QuantuMope/grimdor-shoe-tying-robot/Design Conception Drawings/gear box 1.png

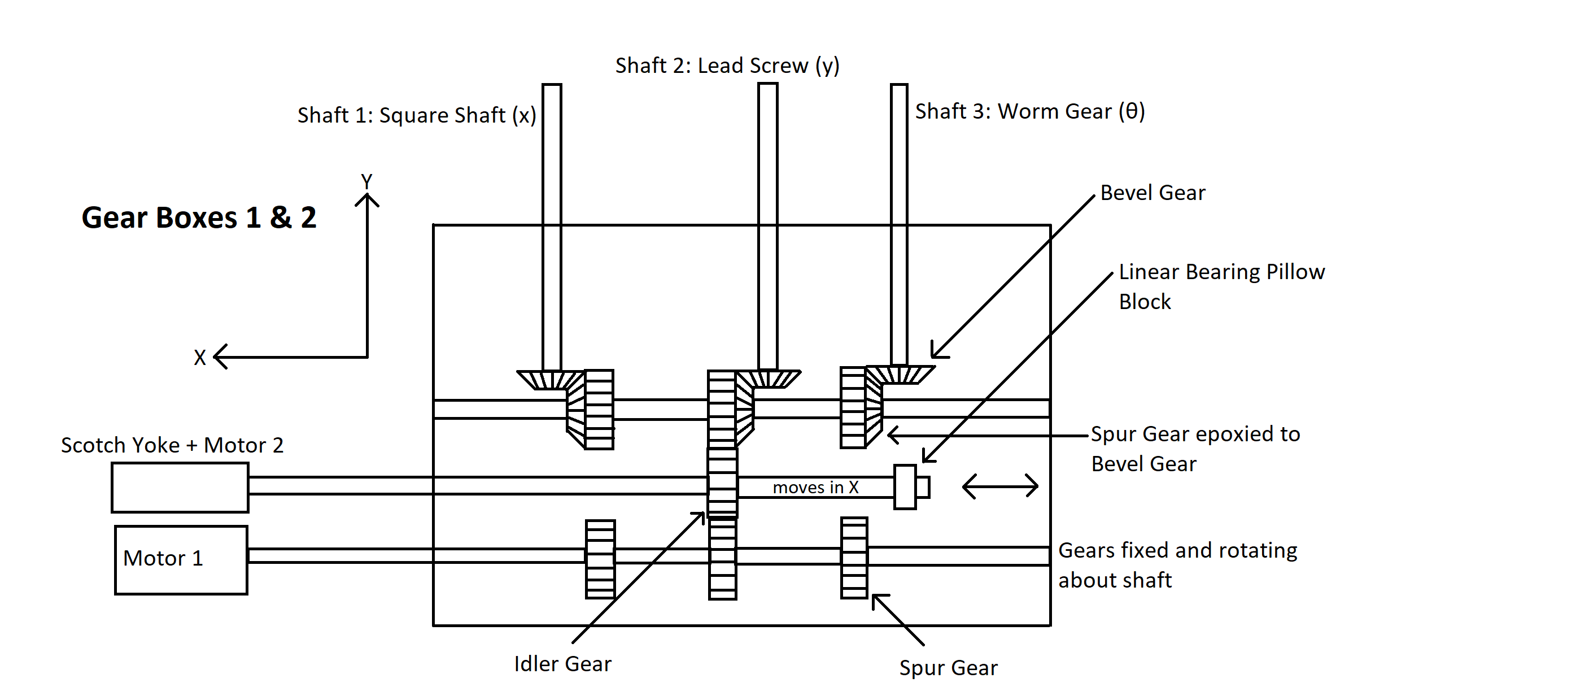
Design Conception Drawings/gear box 1.png
