QuantuMope/grimdor-shoe-tying-robot/Design Conception Drawings/gear box 3 top view.png

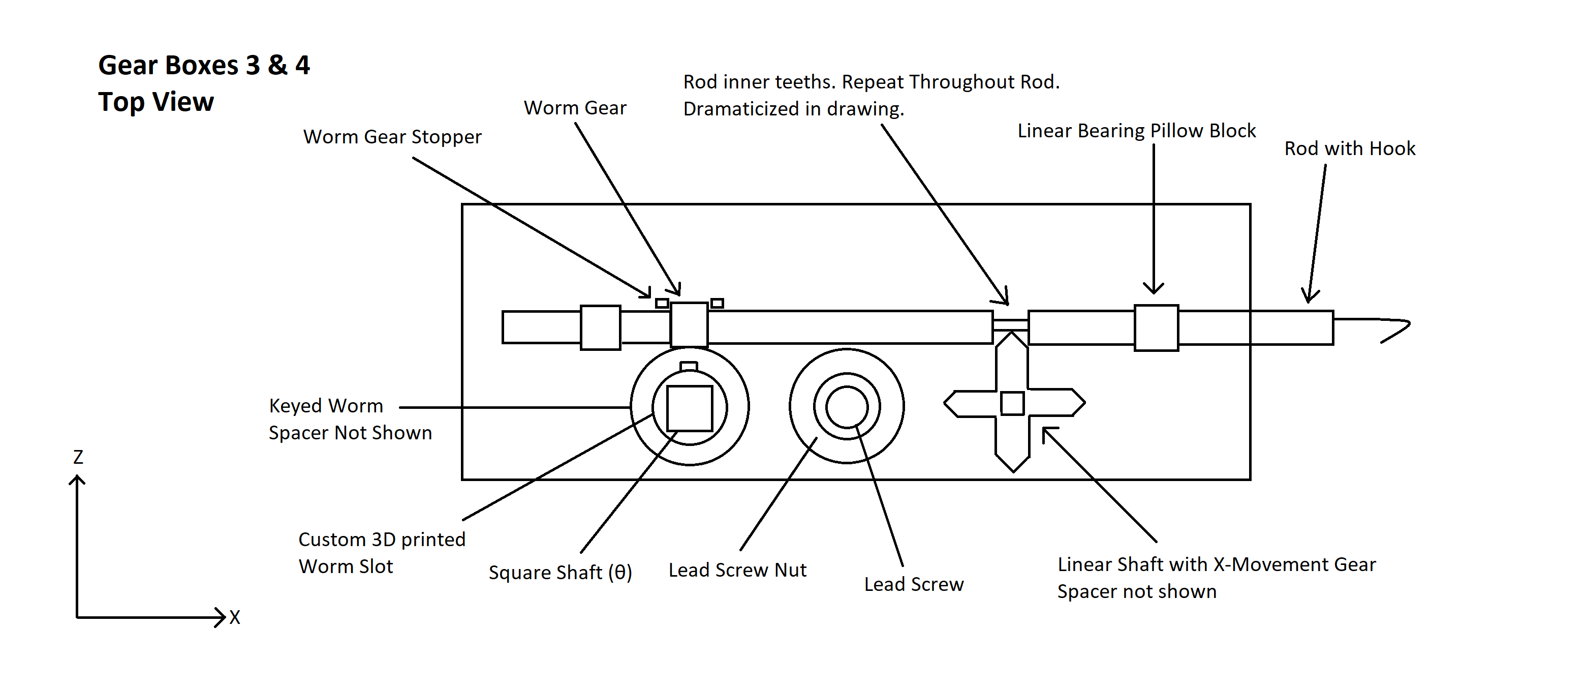
Design Conception Drawings/gear box 3 top view.png
