QuantuMope/grimdor-shoe-tying-robot/Design Conception Drawings/Gear box 3.png

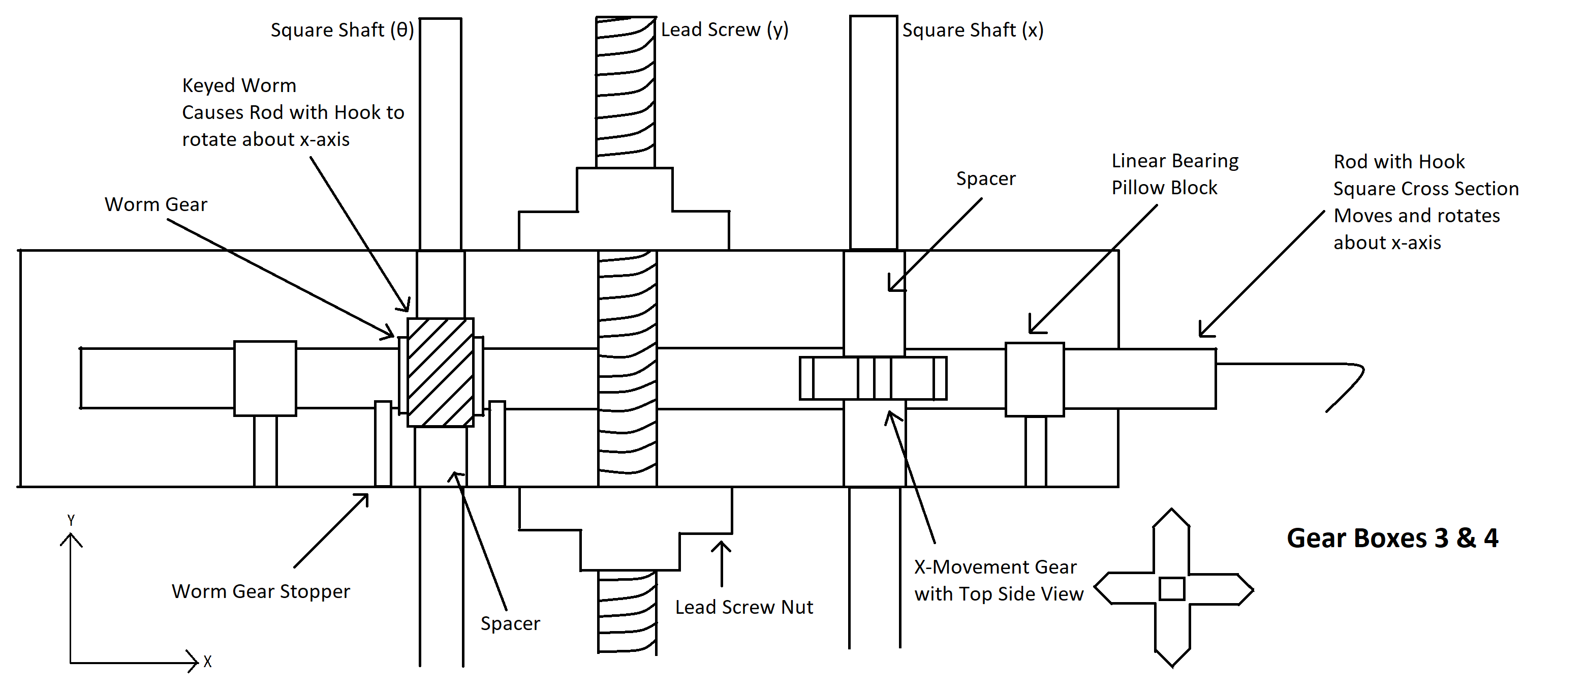
Design Conception Drawings/Gear box 3.png
