QuantuMope/grimdor-shoe-tying-robot/Design Conception Drawings/Gear Box Configuration.png

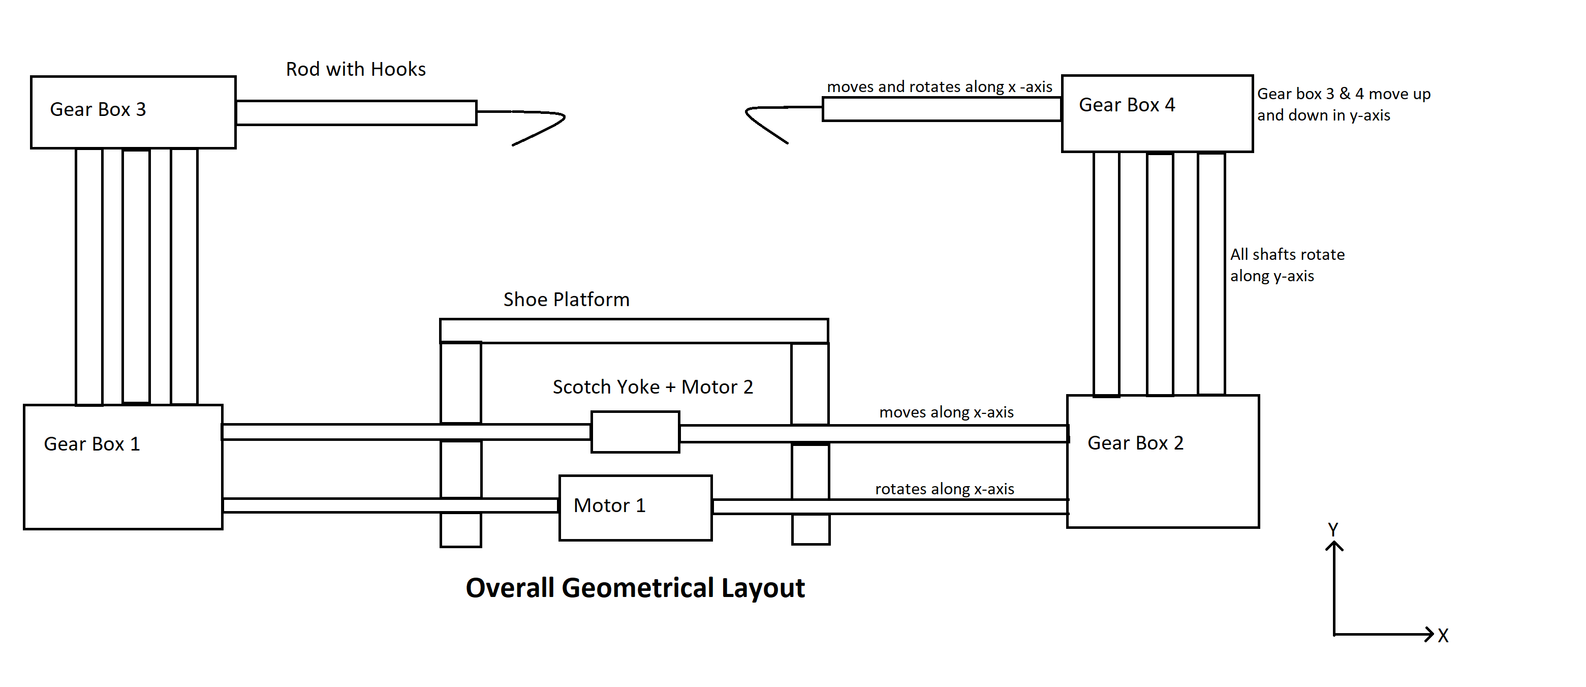
Design Conception Drawings/Gear Box Configuration.png
