QuantuMope/grimdor-shoe-tying-robot/Design Conception Drawings/STM Circuit Schematic Final.PNG

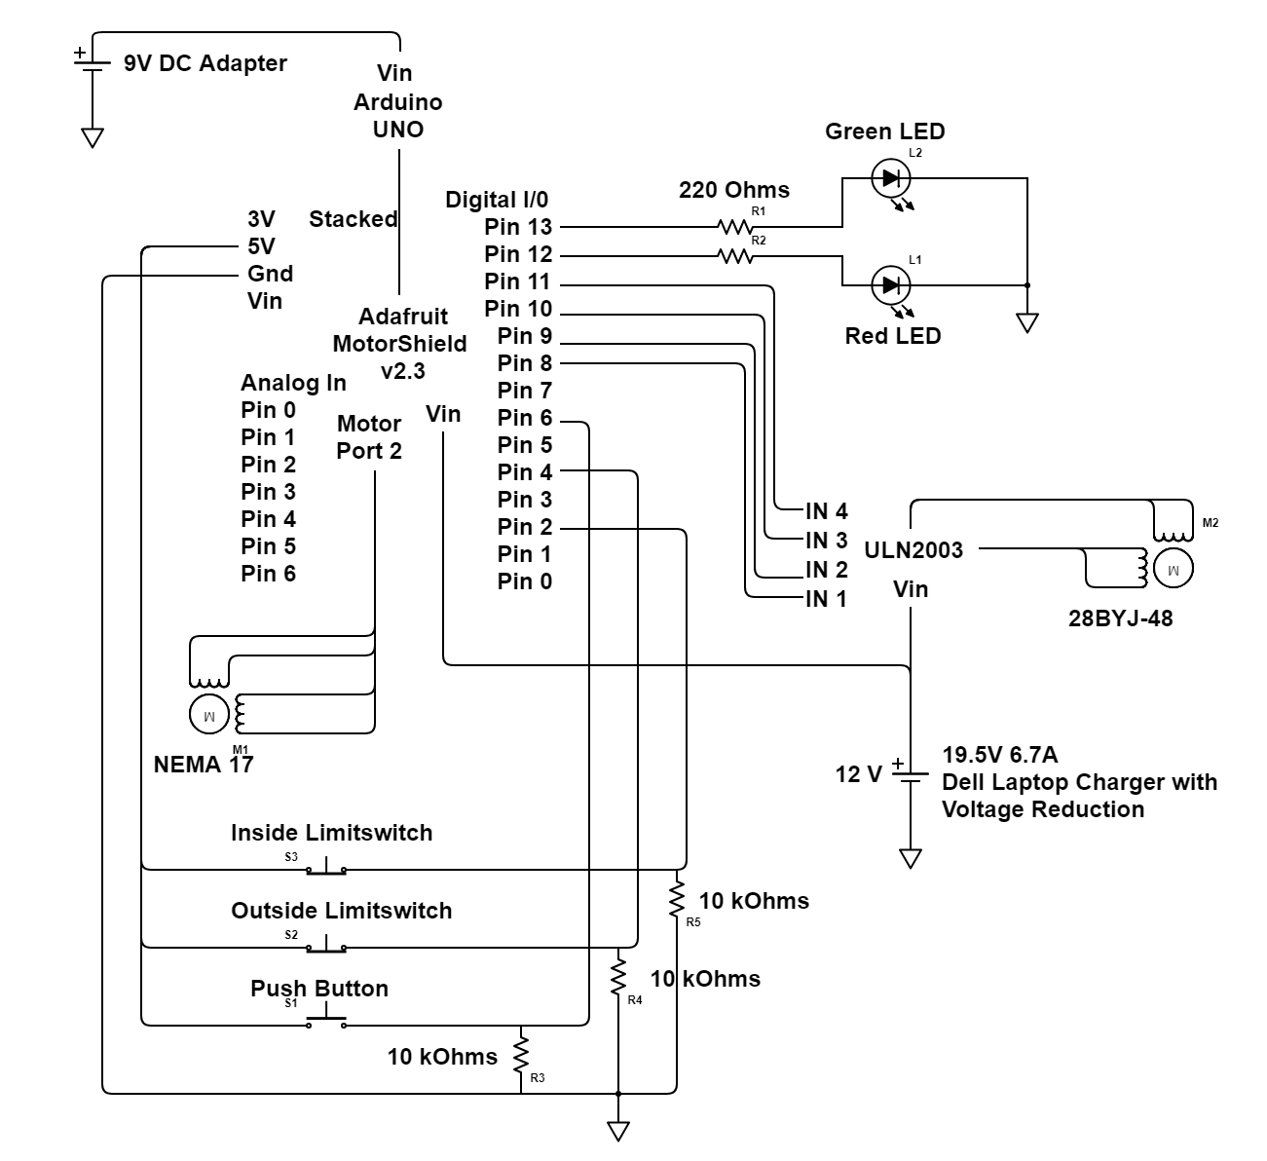
Design Conception Drawings/STM Circuit Schematic Final.PNG
