QuantuMope/grimdor-shoe-tying-robot/Final_Render/FinalAssemblyRender.JPG

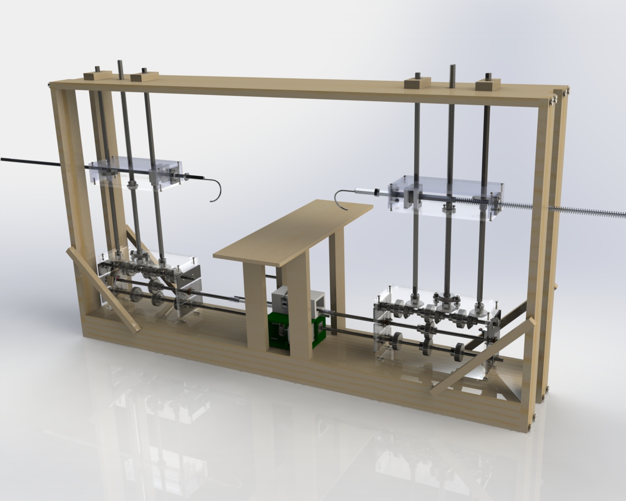
Final_Render/FinalAssemblyRender.JPG
