QuantuMope/grimdor-shoe-tying-robot/Shoe Tying Robot Report.PDF

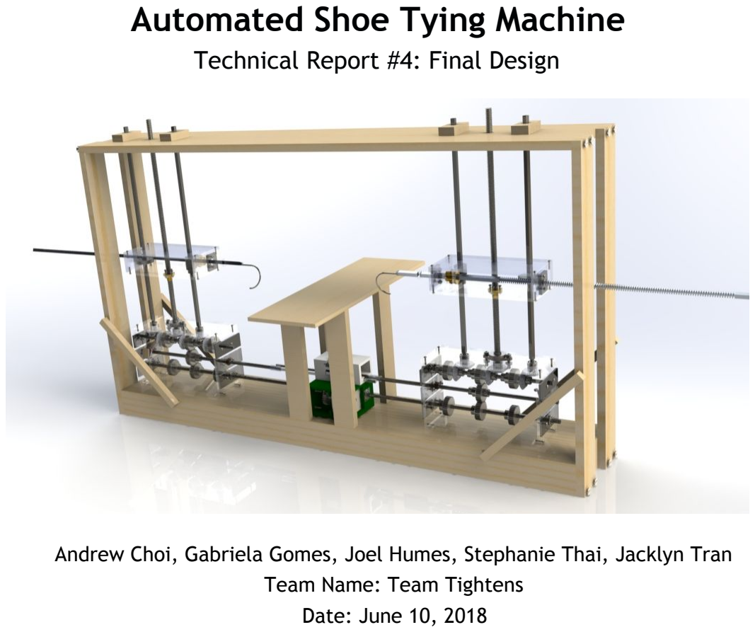
[picture p8: page 1]

Automated Shoe Tying Machine
Technical Report #4: Final Design

Andrew Choi, Gabriela Gomes, Joel Humes, Stephanie Thai, Jacklyn Tran

Team Name: Team Tightens
Date: June 10, 2018

Introduction

Mission Statement
Having neatly laced and tied shoes on our feet is a luxury the majority of us take for granted. Tying our shoes is a skilled learned at a young age that becomes a second nature ability. As we age though, our hand dexterity may decrease, our back begins to ache, and we lose flexibility. All these factors can lead to losing our ability to tie our shoes. Imagine being hindered from performing one of your earliest skills due to your age, a new disability, or during the challenges of pregnancy. It can be very disheartening to lose your long held ability to wear shoes that define part of your style and personality and be forced into settling for simple strapped shoes and slip ons that just aren’t the same. In order to challenge this issue and bring back a sense of confidence, dignity, and independence to people who’ve been forced into wearing laceless shoes, our team’s mission is to develop a fully automated shoe tying machine that works for them. There exist hobbyist machines that demonstrate knot tying capabilities but none that would be of use for the elderly, as all are not fully automated and require the user to secure the laces to preset locations. Our primary sponsor is Professor Moore from the University of California, Davis and we were given the directive to design based on our main competition evaluation criteria: time it takes to tie a shoe, the amount of energy the machine consumes, and the machine’s overall success rate over multiple runs. Although the driving factor in the design parameters lies with winning the competition, we hope that our shoe tying machine can act as a precursor for a more practical future iteration of a shoe tying machine that can be widely used and benefit the elderly and disabled community, our primary stakeholders.

Problem Description
Often, the elderly and/or disabled have difficulties grabbing and tying their shoelaces on their own, so they have to resort to wearing velcro shoes, slip ons, or seek assistance from a care provider. Therefore, an automated shoe tying machine that is capable of tying a safe and lasting initial and final standard shoelace knot (shown in Figure 1 below), without requiring human assistance, has been designed and manufactured so that the user can gain more independence.

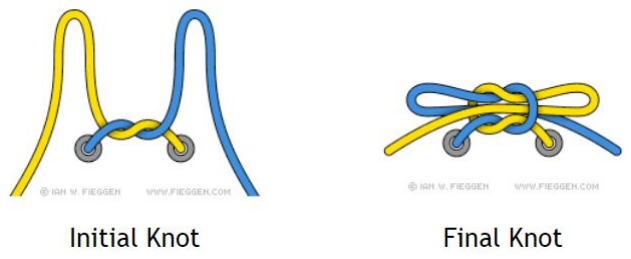
[picture p9: figure]

Figure 1. Examples of the initial knot and final standard shoelace knot [1].

In creating such a machine, the problem was broken down into several, more manageable sub-problems as follows:
Sub-Problems
1. Power - How will the shoe tying machine be powered?
2. Controls - How will the shoe tying machine be automated?
3. Actuators - What type of motors will be used?
4. Lace Grabbing Mechanism - How will the shoe tying machine grab the laces?
5. Moving Mechanism - How will the two motors move the lace grabbing mechanism?

These sub-problems address the major functions of the shoe tying machine that our design concept must address. Overall, a shoe tying machine will enable more independence for the elderly and disabled in tying their shoes. Farther downstream market applications may include use of the machine as a novelty device in a shoe store or assistive device in well equipped locker rooms.

Existing External Concepts/Solutions
Several external concepts were researched to aid the design of the shoe tying machine. Among these external concepts, no fully automated machine was found but certain components of these concepts inspired ideas. One external concept is a patented shoe tying device created by Leah D. Holmes et al. [2]. A schematic of this device can be seen in Figure 8 of the Appendix. This machine was designed to assist individuals with at least one able hand. Although our machine must be fully automated, we gained valuable insight from the design’s use of one motor for symmetrical motion. Another device uses rods and fixture patterns to secure and tie a free string into the final knot; the string is tied as the fixtures are carefully removed layer by layer and the rods are lowered simultaneously [3]. Although this device did not tie the knot with a string attached to a shoe, insight was gained by the simplicity of using layers to tie a knot. Furthermore, the usage of simple rods with hooks for the lace grabbing mechanism was inspired by a shoe tying robot created by Andrew Stone, a mechanical engineering student at the University of Minnesota [4].

Needs, Specifications, and Standards

Since the project is meant for a competition rather than commercial viability, the needs derived from competition evaluation and parameters, which are listed below, are of highest priority and essentially drive the specifications of the shoe tying machine. Competition Parameters

1. Must only use up to two motors.
2. Must be powered through a wall outlet.
3. Must be able to grab the shoelaces without human assistance.
4. Must tie a standard shoe knot on a stationary shoe.
5. Must stay under a $600 budget.

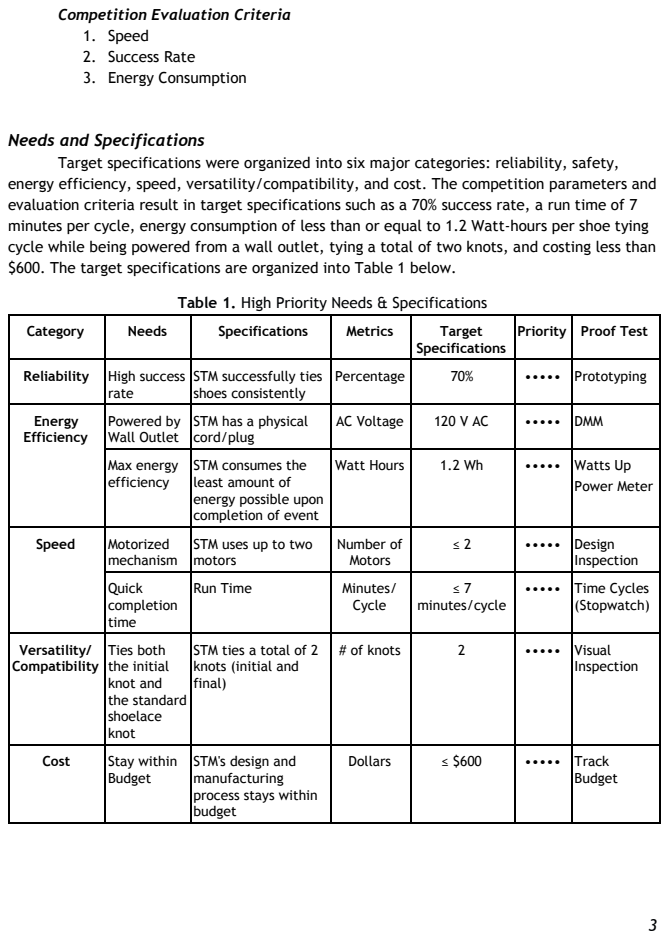
[picture p10: page 4]
Table 1.; High Priority Needs & Specifications

Competition Evaluation Criteria
1. Speed
2. Success Rate
3. Energy Consumption

Needs and Specifications
Target specifications were organized into six major categories: reliability, safety,
energy efficiency, speed, versatility/compatibility, and cost. The competition parameters and
evaluation criteria result in target specifications such as a 70% success rate, a run time of 7
minutes per cycle, energy consumption of less than or equal to 1.2 Watt-hours per shoe tying
cycle while being powered from a wall outlet, tying a total of two knots, and costing less than
$600. The target specifications are organized into Table 1 below.

Category | Needs | Specifications | Metrics | Target Specifications | Priority | Proof Test

Reliability | High success rate | STM successfully ties shoes consistently | Percentage | 70% | ••••• | Prototyping

Energy Efficiency | Powered by Wall Outlet | STM has a physical cord/plug | AC Voltage | 120 V AC | ••••• | DMM

Max energy efficiency | STM consumes the least amount of energy possible upon completion of event | Watt Hours | 1.2 Wh | ••••• | Watts Up Power Meter

Speed | Motorized mechanism | STM uses up to two motors | Number of Motors | ≤ 2 | ••••• | Design Inspection

Quick completion time | Run Time | Minutes/ Cycle | ≤ 7 minutes/cycle | ••••• | Time Cycles (Stopwatch)

Versatility/ Compatibility | Ties both the initial knot and the standard shoelace knot | STM ties a total of 2 knots (initial and final) | # of knots | 2 | ••••• | Visual Inspection

Cost | Stay within Budget | STM's design and manufacturing process stays within budget | Dollars | ≤ $600 | ••••• | Track Budget

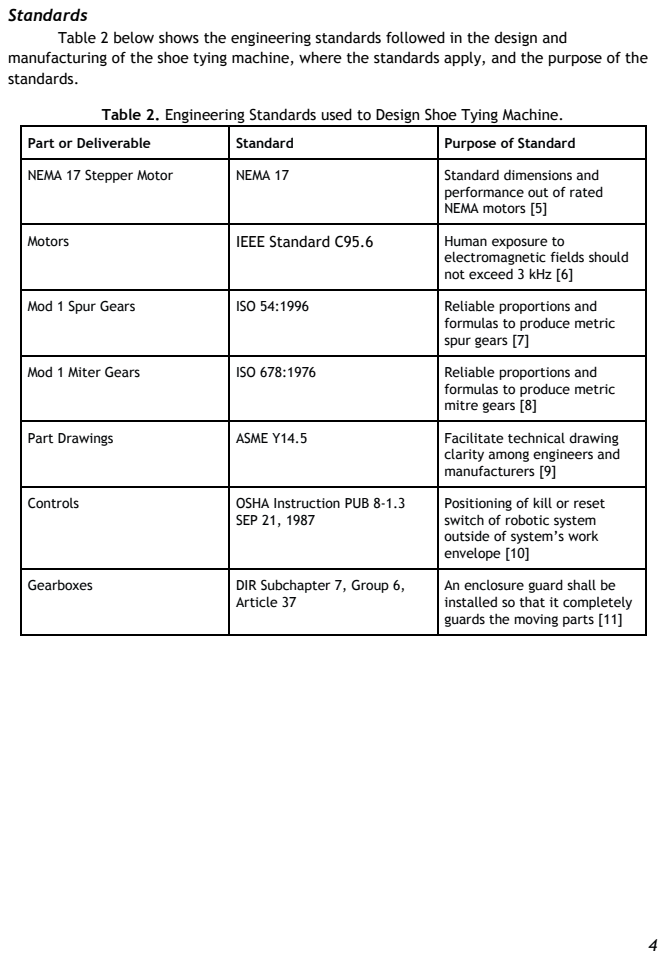
[picture p11: page 5]
Mod 1 Miter Gears; ISO 678:1976; Reliable proportions and; Part Drawings; ASME Y14.5; Facilitate technical drawing; Controls; OSHA Instruction PUB 8-1.3; SEP 21, 1987; Gearboxes; DIR Subchapter 7, Group 6,; Article 37

Standards
Table 2 below shows the engineering standards followed in the design and
manufacturing of the shoe tying machine, where the standards apply, and the purpose of the
standards.

Table 2. Engineering Standards used to Design Shoe Tying Machine.

Part or Deliverable | Standard | Purpose of Standard

NEMA 17 Stepper Motor | NEMA 17 | Standard dimensions and performance out of rated NEMA motors [5]

Motors | IEEE Standard C95.6 | Human exposure to electromagnetic fields should not exceed 3 kHz [6]

Mod 1 Spur Gears | ISO 54:1996 | Reliable proportions and formulas to produce metric spur gears [7]

formulas to produce metric
mitre gears [8]

clarity among engineers and
manufacturers [9]

Positioning of kill or reset
switch of robotic system
outside of system’s work
envelope [10]

An enclosure guard shall be
installed so that it completely
guards the moving parts [11]

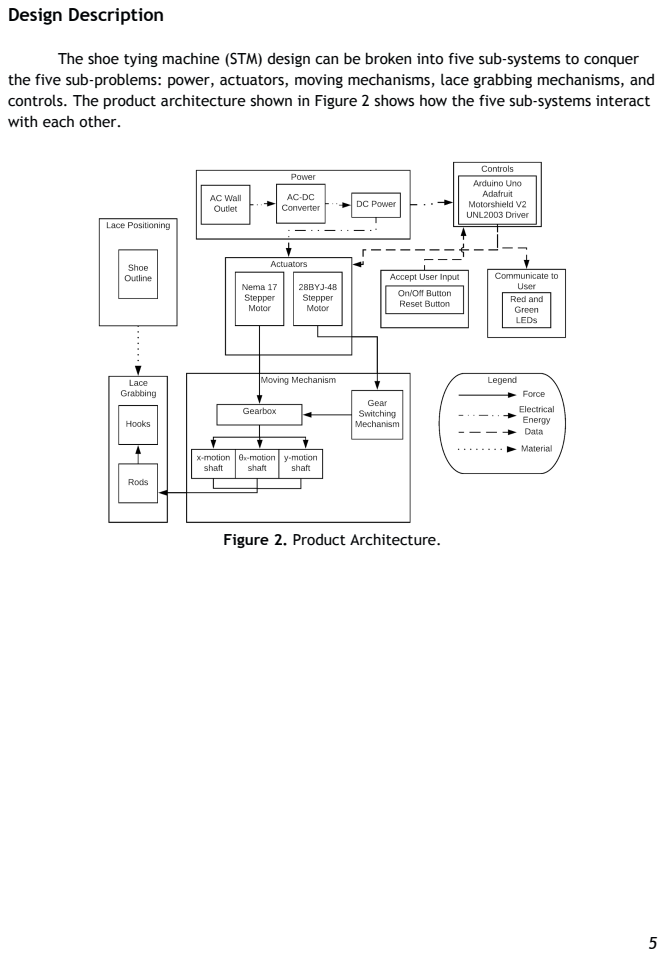
[picture p12: page 6]
Design Description; Figure 2.; Product Architecture.

The shoe tying machine (STM) design can be broken into five sub-systems to conquer
the five sub-problems: power, actuators, moving mechanisms, lace grabbing mechanisms, and
controls. The product architecture shown in Figure 2 shows how the five sub-systems interact
with each other.

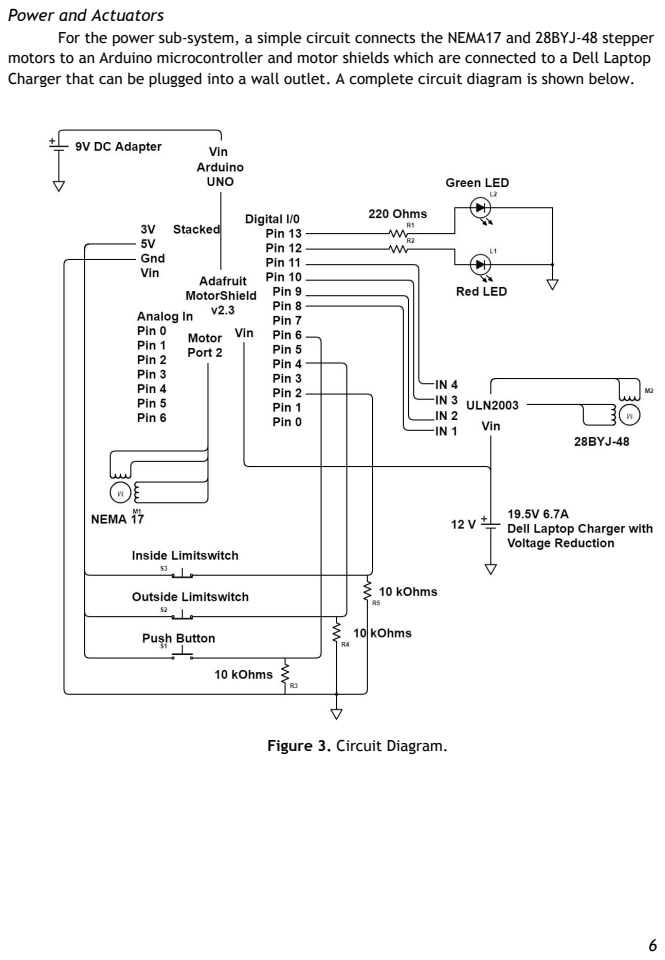
[picture p13: page 7]

Power and Actuators
For the power sub-system, a simple circuit connects the NEMA17 and 28BYJ-48 stepper
motors to an Arduino microcontroller and motor shields which are connected to a Dell Laptop
Charger that can be plugged into a wall outlet. A complete circuit diagram is shown below.

Figure 3. Circuit Diagram.

Moving Mechanisms
The two motors actuate four gearboxes, two on each side of the shoe platform as shown below.

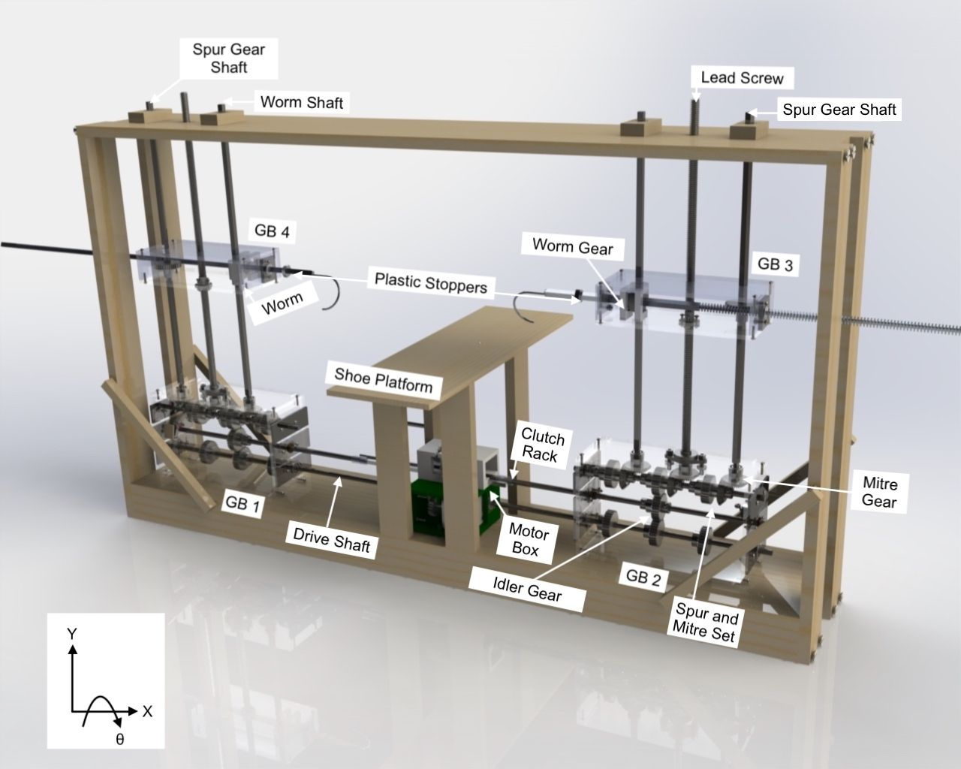
[picture p14: figure]

Figure 4. Rendered CAD model with Integral Parts Labeled.

In the bottom gearboxes (GB1&2), 30 tooth spur and mitre gears transmit power from the NEMA 17 motor and translate horizontal shaft rotation to vertical shaft rotation. The NEMA 17 motor drives a shaft connected to GB1&2 on the two sides of the shoe platform. On the drive shaft are a total of six 30 tooth spur gears, three inside each gearbox on each side. A 30 tooth idler gear in each gearbox transmits rotations from the bottom spur gears to the spur-mitre gear sets on the top shafts. The 28BYJ-48 motor controls the horizontal movement 1 of the idler gears using a rack and pinion system; the racks translate the idler gear shafts horizontally. The idler gear then engages with corresponding spur-mitre gear sets, and transfers power from the drive shaft to the spur-mitre gear sets which drive the movement of two rods with hooks in the top gearboxes (GB3&4). Often times the clutch gear teeth aligns perfectly with another set of teeth and jams the clutch mechanism. Rubber bands are used to hold the clutch motorbox in place while also giving it the ability to shift slightly until the clutch is able to fix itself. The top gearbox is controlled by two square shafts and a lead screw

1 Mitre gear epoxied to a spur gear.

on each side. The lead screw controls translational y-axis movement. Square shafts are used so that the top gearboxes can move along the shafts and the gears on the shafts can be engaged and driven by each shaft at any point along the shaft. The square shaft closest to the shoe platform (Worm Shaft) drives a worm and a 20 tooth worm gear with a modulus of 1 which controls the rotation of the rod about the x-axis. The worm was purchased and it had a circular bore so an acrylic insert sits inside the worm using the set screw and has a square bore that would allow the square shaft to rotate the worm. Last, the square shaft farthest away from the shoe platform (Spur Gear Shaft) controls the translational x-axis movement of the rod by driving a 33 tooth, modulus 1 spur gear with a 0.25”x0.25” square bore. The hook rod is designed to have 12.89” of rack with a modulus of 1 and is driven by the spur gear. The spur gear was restricted by the worm and worm gear because the distance between the worm and worm gear needed to match the distance between the spur and hook rod so that the hook rod would be straight while both gear systems maintained a strong mesh. Collars were used to secure the positions of the gears and shafts.
After multiple test iterations of the shoe tying algorithm using a simple wooden prototype, it was determined that a 0.5” offset of the hooks was the ideal position. This offset determined most of the design aspects because everything under the hooks had to be offset in order for the hooks to be offset. Slots were designed in the side plates of GB1&2 to allow for adjustability of the gears in order to achieve the best gear meshing. Two different sets of slots were designed into the side plates: one was for the drive shaft and the other for the idler gear and spur-mitre gear sets. The drive shaft slots were identical for both GB1&2 because there was only one drive shaft. But the slots for the idler and spur-mitre gear sets are offset by 0.25” from the drive shaft slots in opposite directions on each gearbox so that the total offset is 0.5”.

Lace Grabbing Mechanism
The shoelaces were controlled with a pair of hooks. Two paper clips with a diameter of 0.1” were used to make hooks with 0.75” diameters designed to reach across the 0.5” offset and grab the opposing laces. The rod was designed to be a square shaft to allow translational movement through the worm gear but also be able to be rotated by the worm gear when needed. Since the worm gears had circular bores, acrylic inserts with a square bore were placed inside the worm bear bore. The set screw of the worm gear was used to hold the acrylic inserts in place. The square bore would catch the square rod and rotate the rod as the worm gear rotated. There are also plastic stoppers on the hook rod about 3.34” away from the hook. These stoppers prevent the shoelaces from moving along the hook rod as it moves inwards toward the shoe. They stop the shoelaces so that the hooks on the opposite rod are able to grab the lace during the shoe tying operation. The flexibility and elasticity of the stoppers were an integral part of the design. The stoppers needed to be stiff enough to hold the shoelaces back but flexible enough to bend when the hooks hit it.

Design Justification

Motor Justification
Clutch Motor: 12V 28BYJ-48 Stepper
In choosing the clutch motor, a major limitation was created by the necessary 0.5” offset between the clutch rods. To satisfy the 0.5” offset, a thin motor shaft that could fit a 0.3”OD laser cut spur gear was needed. Additionally, a second NEMA17 was nearly chosen to act as the clutch motor for its speed and energy efficiency but was decided to be infeasible due to its larger shaft size which would lead to fragile spur gear. Therefore, to satisfy this offset, the 28BYJ-48 motor was chosen instead for its small size, relatively high torque, and most importantly its 5mm shaft. Although the 28BYJ-48 has speeds of up to only 20rpm, the small size of the 28BYJ-48 allowed the 0.5” offset to be possible. Therefore, the lower speed of the 28BYJ-48 was deemed a necessary sacrifice. During testing, this speed proved to be just enough for the machine to achieve the highest success rate.

Drive Motor: 350mA NEMA17 Stepper
For the drive motor, several motors were contemplated: a 350mA NEMA17 that has a 16 Ncm holding torque, a 2A NEMA17 with a 59 Ncm holding torque, and a 2.8A NEMA23 with a 1.9Nm holding torque. The output torque between these motors varied greatly and thus, a decision was made based upon which motor had the highest chance of being able to win the competition. A motor was needed that had high enough speeds to minimize run time, the necessary torque to not stall, and was not unnecessarily strong because that would lead to wasteful energy consumption.
To determine which speeds were desired, a 350mA NEMA17 was purchased as a preliminary test motor. Using this motor, it was shown that slower rpms were often more desirable. High rpms would often cause excessive vibrations throughout the machine due to being made out of acrylic which would led to laces falling off the rod with hooks. It was shown that the 350mA NEMA17 had adequate torque for quick x-translational and x-rotational movements but lacked speed in y-translational movement. Despite this, it was decided to stick with the 350mA NEMA17. The 2A NEMA17 and the 2.8A NEMA23 were deemed to be unnecessarily powerful as the marginal benefits of having a faster y-translational movement time would be overshadowed by the heightened energy usage.

Gear Justification
By selecting motors with sufficient torque, the correct gear ratios were chosen – specifically, the gears between the motor shaft and the drive shaft which has a 4:5 gear ratio (20T:25T). Otherwise, to simplify the overall design, all other gears have a 1:1 ratio with module of 1.

Circuit Justification
Motor Shield: Adafruit Motorshield V2.3 and ULN2003
In determining proper motor drivers for the NEMA17 and 28BYJ-48, the Adafruit Motorshield V2.3 and the ULN2003 motorshields were chosen, respectively. The Adafruit

Motorshield V2.3 was chosen for its easy and intuitive Arduino library as well as its ability to microstep stepper motors which was necessary for smooth clutch transitions. The Adafruit’s 1.2A current support was also more than adequate for powering the 350mA NEMA17. The ULN2003 was chosen as it is a standard for controlling 12V 28BYJ.48 steppers. Furthermore, as the Adafruit shield is powered through a 12V source, both shields were able to be powered through the same power source which led to a more convenient circuit setup.

Meeting Specifications
The majority of target specifications were met by the shoe tying machine which include the competition parameters as well as desired competition evaluation parameters. All competition parameters were met as the STM
- Stayed under a $600 budget, costing a total of $580.90
- Is powered through a wall outlet using a 19.5V 6.7A Dell Laptop charger with a DC to DC step down converter
- Used only two motors: a 12V 28BYJ-48 and 350mA NEMA17

For contest evaluation parameters, several target values were predetermined that we believed would make the STM competitive with the Japanese team. These values and the actual outcomes are discussed below.

Speed
A target specification of under 7 minutes was chosen for speed. Using the aforementioned two motors, the total shoe tying operation was timed to be 4 minutes and 10 seconds, far exceeding expectations. Thus, the STM design met the speed criteria.

Energy Efficiency
For energy efficiency, a total energy consumption of under 1.2 Wh was calculated by first calculating the power consumption of both stepper motors and then finding the total power consumption. Last, the target time per cycle (7 minutes) was used to calculate the target total energy consumption, which ended up to be 0.96 Wh. Since stepper motors often consume more than their rated current at peak times, this energy consumption was multiplied by a factor of 1.25 for a total energy consumption of 1.2 Wh. This calculation is shown below.

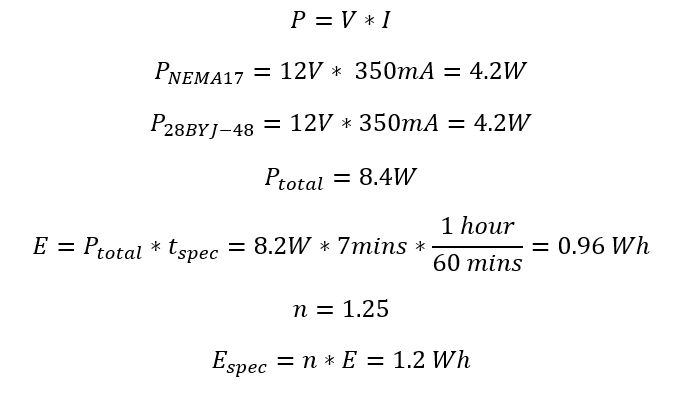
[picture p15: figure]

Using the Watts Up meter, the total power consumed by the machine in one cycle was measured to be 0.6 Wh. This value makes sense as the time it took to complete the shoe tying algorithm decreased from 7 minutes to 4 minutes and 10 seconds. Therefore, the STM design met the energy efficiency criteria.

Success Rate
A target success rate of 70% was chosen as it was thought to be highly competitive. In actuality, after testing, the success rate of the first initial knot came out to be approximately 90% while the completion of the second knot dropped down to 30%. The STM design did not satisfy this specification due to the complexity of getting laces to act consistently between trials. Although the overall success rate of 70% was not achieved, the 30% success rate is still satisfactory as it was enough to win the competition.

Manufacturing

Manufacturing consisted of several main sub-assemblies listed below:
- Gearbox Frames
- Vertical Shafts
- Horizontal Shafts
- Gears/Racks/Inserts
- Motorboxes
- Rods with Hooks
- Mounting Plates/Acrylic Bearings
- Wood Frame

Gearbox Frames
Gearbox frames were made out of cast acrylic for its ease of manufacturing, relative sturdiness, as well as its opacity. Each gearbox frame consists of four plates: bottom, top, and sides for a total of 16 plates. Front and back plates were excluded to allow for rapid troubleshooting. Each plate was approximately 0.18 inches thick with a tolerance of ±0.01 inches. All of the plates were cut with the Trotec Speedy 400 Laser. Holes were then drilled into the sides of the plates using a #43 drill bit on a Bridgeport mill. These holes were then tapped for 4-40 screws. The side plates have 3 slots that allow for mounting plates to be fixed using 4-40 screws and nuts. The top plates for gearboxes 1 and 2 have holes to which ⅝” bearings are press fit and the lead screw bearing is mounted. The top and bottom plates for gearboxes 3 and 4 have 0.35” diameter holes so that the vertical 0.25” square shafts can fit through. The middle hole on the bottom plate of gearboxes 3 and 4 have a lead screw nut screwed into it using 4-40 screws. These plates were then held together using 4-40 screws to create the frames for each gearbox.

Vertical Shafts
Three vertical shafts were used on each side of the machine: two 0.25” cold rolled mild steel square shafts and a 8mm stainless steel lead screw. The lead screw was used as is and a turning tool on a lathe was used to turn down the 0.25” vertical shafts to 0.25” diameter circular shafts 1.5 inches from the top and bottom end so that the shafts can sit in the bores of the bearings, collars, and mitre gears.

Horizontal Shafts
Three 3 feet cold rolled mild steel 0.25” circular rods were used for the horizontal shafts. The first shaft was used as is for the drive shaft. The second shaft was cut into two 8.75” shafts for the two top rods. The third shaft was cut into two 15” shafts for the middle clutch rods. All rods had their ends deburred on a belt sander.

Gears/Racks/Inserts
Gears consisted of 12 acetal mitres, 14 acetal spurs, two bronze worm gears, two 1045 steel worms, and 5 cast acrylic spurs. Reamers were used on the lathe to drill out the bores of many of the gears. The mitre gears had their original 6mm bore expanded to 6.35mm so that they would fit onto the 0.25” horizontal and vertical shafts. The other two mitres were drilled out ot 8mm to fit onto the lead screws. All 14 of the acetal spur gears had their bores drilled out to 0.25”. Six of the mitres were epoxied concentrically to six spurs. These spur-mitre gear sets as well as the rest of the spurs had their teeth faces shaved down using a dremel for tip relief during clutch shifting; this lowered the probability of the clutch gear teeth running directly into the other spur teeth and jamming the clutch. The two 1045 steel worms had their bores drilled out to 10mm. The cast acrylic spurs in gearbox 3 and 4, and in the two motorboxes were cut using the Trotec Speedy 400 Laser. Cast acrylic inserts were created to fit into the worm bores to create square bore shapes to fit onto the vertical shafts and rod with hook. These acrylic inserts were laser cut into 10mm OD and 0.25” square inner bore pieces. These were then acrylic cemented on top of each other to fit along the worm and worm gear lengths. Acrylic racks for the clutch motorbox were laser cut and couplers were used to connect the racks to the clutch shaft; acrylic cement was used to attach the coupler to the racks and friction from rubber was used to hold the coupler to the steel clutch shaft. All acrylic pieces were 0.25” thick.

Motorboxes
Motorboxes were 3D printed with polylactic acid (PLA) material. Each motorbox was printed in halves so that the surfaces were as smooth as possible with no overhangs. The halves were then epoxied together. The 28BYJ-48 stepper motor was secured onto the clutch motorbox using two 1.15” 6-32 screws and nuts. The NEMA17 motor was secured onto the drive motorbox using four M3 socket head screws. Because bearings were needed to hold the drive shaft and 3D printing does not print perfect circles, cast acrylic bearing inserts were laser cut and put into the drive motorbox on each of its sides to ensure a perfect circle for the bearings.

Rod with Hooks
The rod with hooks were made from 6061-T6 aluminum by cutting a 3’ x 1” plate into to two 21.2” x 0.25” square shafts. A Bridgeport mill was then used to make the custom racks on each face of the square shaft using a CNC program and an 1/16” (0.0625”) end mill to perform the following motions: move up in a vertical line perpendicular to the rod, offset to the right to complete the gap between the teeth (0.071”), and move down in a vertical line perpendicular to the rod. These motions were then repeated 105 times for each face of each square shaft.

Mounting Plates/Acrylic Bearings
Mounting plates were made for the rods with hooks in gearboxes 3 and 4, as well as the horizontal shafts in gearboxes 1 and 2. Cast acrylic bearings were laser cut with 0.55” OD and a 0.25” square bores and were held in the mounting plates for gearboxes 3 and 4 using washers and 4-40 screws and nuts so that the rods with hooks could freely rotate in the mounting plates. All were made with 0.125” cast acrylic. For gearboxes 1 and 2, the four bottom mounting plates have 0.625” bearings press fit into the middle hole. The four middle mounting plates have 0.375” oil impregnated bronze bushings press fit into the middle hole. The top four mounting plates have the 0.25” circular shaft press fit into the middle hole. All mounting plates are secured using 4-40 screws and nuts.

Wood Frame
The wood frame was manufactured using a 2’ x 4’ x 0.5” plywood to keep the machine level and make it easier to transport. Additionally, the side walls have a gap in order to allow the rods with hooks to travel up and down and in and out of the gearboxes. Furthermore, the roof of the frame has three 10mm holes on each side to allow each vertical rod to pass through, and blocks with 0.625” holes for press fitted bearings were added to the top each square rod to stabilize and reduce friction in their rotation.

Assembly
With all the major pre-assemblies completed, the overall shoe tying machine can be assembled. Assembly consists of the following chronological steps.
1. Gearbox frames are screwed together.
2. Idler shafts and top shafts are fitted through the slots of each side plate of gearboxes 1 and 2 with the respective mounting plates on the outsides of the frame. Three spur-mitre gear sets are put onto the top shafts while one acetal spur is placed into the idler shaft. Collars are used to secure the positioning of the gears.
3. The bottom drive shaft is driven through gearbox 1, the motorbox, and then gearbox
2. Three acetal spur gears are placed onto the shaft inside both gearbox 1 and 2. These gears are secured to the shaft using set screws. An acrylic spur gear is placed onto the shaft inside the motorbox and is secured using collars and glue. Mounting plates are also used on the outside sides of both gearbox 1 and 2.
4. Mounting plates are leveled and secured by 4-40s and nuts to the proper heights for proper gear meshing.
5. Two vertical shafts are secured onto the top plates of gearboxes 1 and 2 each. Both square shafts and the lead screw have a mitre gear fit onto it after being placed through a bearing mounted onto the top plate. The square shafts are held up by collars while the lead screw is set screwed into the lead screw bearing mount at levels where the mitres properly mesh with the spur-mitre gear sets on the top shaft.
6. Gearboxes 3 and 4 are then placed through the vertical shafts. The worm with inserts and the acrylic spur with spacers are placed through their respective square shafts inside gearboxes 3 and 4. At this point, gearboxes 3 and 4 should be held up entirely by gearboxes 1 and 2.
7. The gearboxes are then placed onto the wooden frame. The vertical square shafts are straightened and stabilized by a bearing that is mounted on the top of the wooden frame. The lead screws simply go through a hole the top of the wooden frame. Gearboxes 1 and 2 are held in place by wooden stoppers that are glued to the frame.
8. The NEMA17 motor is now screwed into the drive motorbox using M3-.05x10 screws. A cast acrylic 20 tooth spur gear with a d-bore is placed into the NEMA17’s d-shaft and secured where it meshes with the other 25 tooth spur gear inside the drive motorbox. The clutch motorbox is placed right above the drive motorbox and is fastened with rubber bands onto an acrylic plate that is glued onto the drive motorbox and the wooden frame. The clutch rods are then secured onto the couplers of the clutch motorbox racks.The 28BYJ-48 stepper motor is secured into the clutch box using 6-32s and has an acrylic spur gear secured on the double d-shaft.
9. The NEMA17 and 28BYJ-48 wires are fed through and connected to the main circuit board. Limit switches are also installed on the inner side plate of gearbox 2 and the outer side plate of gearbox 1 in the area of the clutch shaft.
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
